kovistvan/tt_um_ik_0_ptat_bgr/README.md

# Analog Bandgap Reference: pseudo-IPTAT * R + VBE

A simple bandgap voltage reference based on a pseudo-PTAT current generator with enable-gated startup. Schematic entry and simulation are done in **xschem / ngspice**.

## Overview

This block generates a temperature-stable reference of approximately **1.2 V** from a **1.8 V** analog supply. A 1:8 NPN bipolar pair develops a ΔV<sub>BE</sub> across `RGND` to produce a PTAT current. The PTAT current is then mirrored and injected into a `R + V_BE` branch, where the negative temperature coefficient of V<sub>BE</sub> compensates the positive temperature coefficient of IPTAT, yielding a near-bandgap output with low temperature dependence.
Enable-gated startup branch ensures the bgr loop leaves zero-current operating point when the supply ramps. The startup enable `en_start` is tied to `avdd`.

## Schematic

The figure below shows the schematic capture in xschem.



## Theory of operation

- **PTAT core** — 1:8 NPN pair develops ΔV<sub>BE</sub> = (kT/q)·ln(8) across `RGND`, producing
  I<sub>PTAT</sub> = ΔV<sub>BE</sub> / R<sub>GND</sub>.
- **Output branch** — I<sub>PTAT</sub> is mirrored into a series `R + V_BE` combination, so that
  V<sub>REF</sub> = I<sub>PTAT</sub>·R + V<sub>BE</sub>.
  R is sized so the PTAT drop cancels the CTAT slope of V<sub>BE</sub>, giving near-zero TC at room temperature.
- **Startup** — When `avdd` rises, `en_start` (tied to `avdd`) injects a kick current that lifts the loop out of the zero-current state; once biased, the startup branch self-disables and consumes negligible current.

## Pinout

| Pin | Type | Description |
| --- | --- | --- |
| `avdd` (`VDPWR`) | Supply | 1.8 V analog supply |
| `gnd` (`VGND`) | Supply | Analog ground |
| `en_start` | Input  | Startup enable, connected to `avdd` |
| `vbg` (`VREF_TT`)| Output | Bandgap reference output, ≈ 1.2 V |

When the 1.8 V supply is applied, the analog output `VREF_TT` = `vbg` settles close to 1.2 V with low temperature dependence.

## Simulation results

| Parameter | Symbol | Min | Typ | Max | Unit |
| --- | --- | -----: | -----: | -----: | --- |
| Operating temperature | T | −40 | 27 | 100 | °C |
| Supply voltage | AVDD | — | 1.8 | — | V |
| Reference voltage (TT) | V<sub>REF</sub>  |  1.134 |  1.141 |  1.142 | V |
| Reference variation over T  | ΔV<sub>REF</sub> | — | 7.72 | — | mV |
| Temperature coefficient | TC | — | 48.3 | — | ppm/°C |
| PSRR  @ 1Hz | PSRR | — | 41.3 | — | dB |
| PSRR  @ 1MHz | PSRR - worst | — | 3.1  | — | dB |
| Supply current | I<sub>DD</sub> | 5.24 | 6.94 | 8.70 | μA |
| Power consumption | P | — | 12.5 | — | μW |

### Bandgap output vs. temperature

V<sub>REF</sub> swept across the target temperature range; the residual curvature illustrates the second-order error after first-order PTAT/CTAT cancellation.



### Transient startup

Transient response of `VREF_TT` as `avdd` ramps from 0 V to 1.8 V, showing exit from the zero-current state and settling at the nominal reference level.



### PSRR performance



## PVT Simulation results

### Bandgap output vs. temperature

| Corner  | Description | V<sub>REF</sub> @ 27 °C (mV) | TC (ppm/°C) |
| --- | --- | ---: | ---: |
| `tt` | Nom MOS, nom R/C | 1141.8 | 48.3 |
| `ss_hh` | Slow MOS, high R/C | 1152.8 | 65.1 |
| `ff_hh` | Fast MOS, high R/C | 1153.0 | 64.5 |
| `ss_ll` | Slow MOS, low R/C  | 1117.1 | 96.5 |
| `ff_ll` | Fast MOS, low R/C  | 1117.2 | 96.7 |



### Transient startup

vref_tt_pvt_tran

### PSRR performance

psrr_pvt_ac

### 1:8 NPN bipolar pair and output NPN bipolar

The 1:8 NPN pair alongside the NPN dummy devices.



### Layout



### Layout rev1: extendend the circuits to enable circui testability.



### Transient sequence for rev1:

vref_tt_startup_pex

## Tools

- **Schematic / simulation:** xschem, ngspice
- **Layout:** Magic (DRC/PEX) / KLayout (DRC)
- **PDK:** SkyWater SKY130

## License

Released under the Apache-2.0 license. See [`LICENSE`](LICENSE) for details.
