kovistvan/tt_um_ik_0_ptat_bgr/(commit log)

2026-05-07 Enhance documentation for bandgap reference generator
    Updated project documentation to provide specific details about the bandgap reference voltage generator and testing instructions.
2026-05-08 Enhance README with detailed project information
    Expanded the README to include detailed explanations of the bandgap reference voltage generator, its operation, schematic, pinout, simulation results, and tools used.
2026-05-08 Update BGR output section and add temperature data
2026-05-08 Fix table formatting in bandgap output section
    Updated table formatting for bandgap output vs. temperature section in README.
2026-05-16 Update pinout and analog pin names in info.yaml
2026-05-16 Enhance documentation with pin descriptions
    Added detailed pin descriptions for input controls, outputs, and analog pins in the documentation.
